paruru-05/SC-26/README.md

# パーツリストはPCB_Partsのそれぞれのファイルから読み取ってください。過去のものは不安定なため確定後に書き直します。
