paruru-05/SC-26/Firmware/free_pins.md

# Free pins:

## Pico2W

### Definitely

- Pin 10
- Pin 11
- Pin 12

### Reserved

- Pin 2 (BNO085_NRST)

## Pico

### Definitely

- Pin 28 (ADC2)
- Pin 27 (ADC1)

### Reserved

- Pin 13 (DRIBBLER_DIR)
- Pin 14 (DRIBBLER_ENABLE)
