paruru-05/SC-26/PCB_Parts/IR_sensor_ring/jlcpcb/production_files/BOM-IR_sensor_ring.csv

Comment | Designator | Footprint | LCSC | Quantity
2.2nF | C1,C10,C11,C12,C13,C14,C15,C16,C2,C3,C4,C5,C6,C7,C8,C9 | C_0603_1608Metric | C1604 | 16
47kΩ | R1,R10,R11,R12,R13,R14,R15,R16,R2,R3,R4,R5,R6,R7,R8,R9 | R_0603_1608Metric | C25819 | 16
Conn_01x05 | J24,J25,J26,J27 | CONN-SMD_5P-P2.00_B6B-PH-SM4-TB-LF-SN | C265085 | 4
VEMD10940FX01 | U1,U10,U11,U12,U13,U14,U15,U16,U2,U3,U4,U5,U6,U7,U8,U9 | LED-SMD_3P-L3.0-W2.0_LTE-S3201L-ZB-HT | C7104273 | 16
