paruru-05/SC-26/PCB_Parts/main_board/jlcpcb/production_files/BOM-main.csv

Comment | Designator | Footprint | LCSC | Quantity
1.6kΩ | R10,R11,R12,R9 | R_0603_1608Metric | C22369888 | 4
1000uF | C23 | CP_Elec_10x10.5 | C7471896 | 1
100kΩ | R16,R17 | R_0603_1608Metric | C25803 | 2
100nF | C1,C2,C22,C25,C3,C31,C32,C33,C34,C4,C5,C6,C7,C8 | C_0603_1608Metric | C14663 | 14
100Ω | R14,R15,R25,R26 | R_0603_1608Metric | C22775 | 4
10kΩ | R13,R27 | R_0603_1608Metric | C25804 | 2
10nF | C17,C18,C19,C20 | C_0603_1608Metric | C57112 | 4
10uF | C24,C28 | C_1206_3216Metric | C13585 | 2
2.2kΩ | R1,R2,R3,R4 | R_0603_1608Metric | C4190 | 4
2.2uH | L1,L2 | L_Coilcraft_XxL4020 | C122469 | 2
2.7kΩ | R18 | R_0603_1608Metric | C13167 | 1
22kΩ | R5,R6,R7,R8 | R_0603_1608Metric | C31850 | 4
22nF | C13,C14,C15,C16 | C_0603_1608Metric | C21122 | 4
22uF | C26,C27 | C_1206_3216Metric | C12891 | 2
3.3nF | C21 | C_0603_1608Metric | C1613 | 1
470nF | C10,C11,C12,C9 | C_0603_1608Metric | C1623 | 4
470Ω | R19,R20,R21,R22 | R_0603_1608Metric | C23179 | 4
ADS1015IDGS | U7 | TSSOP-10_3x3mm_P0.5mm | C193969 | 1
CD74HC4051PWR | U10,U11 | PW16 | C352826 | 2
CJS-1200B | SW2 | CJS-1200B_NDC | C3664500 | 1
Conn_01x03 | J19,J20,J21,J22 | CONN-SMD_B3B-PH-SM4-TB-LF-SN | C160353 | 4
Conn_01x04 | J1,J15,J16,J7,J8 | CONN-SMD_B4B-PH-SM4-TB-LF-SN | C160354 | 5
Conn_01x05 | J17,J24,J25,J26,J27 | CONN-SMD_5P-P2.00_B6B-PH-SM4-TB-LF-SN | C265085 | 5
DRV8874PWPR | U1,U2,U3,U4 | PWP0016J_N | C1855818 | 4
D_Schottky | D5,D6 | D_SMC | C174037 | 2
IRLML6344TRPBF | U8,U9 | IRLML6344TRPBF_INF | C6285738 | 2
KLJ-1230 | LS1 | KLJ-1230_KKG | C201042 | 1
LED | D1 | LED_0603_1608Metric | C2286 | 1
LED | D3 | LED_0603_1608Metric | C2287 | 1
LED | D2 | LED_0603_1608Metric | C2288 | 1
LED | D4 | LED_0603_1608Metric | C52675996 | 1
SW_Push | SW1 | SW-SMD_L3.9-W3.0-P4.45 | C720477 | 1
TLV9064 | U12 | TSSOP-14_4.4x5mm_P0.65mm | C779410 | 1
TPS62133 | U6 | VQFN-16-1EP_3x3mm_P0.5mm_EP1.68x1.68mm_ThermalVias | C73973 | 1
TPS62162DSG | U5 | Texas_DSG0008A_WSON-8-1EP_2x2mm_P0.5mm_EP0.9x1.6mm_ThermalVias | C40256 | 1
