paruru-05/SC-26/PCB_Parts/main_board/main.kicad_pcb

## KiCad design PCB_Parts/main_board/main.kicad_pcb (2026-11-04)

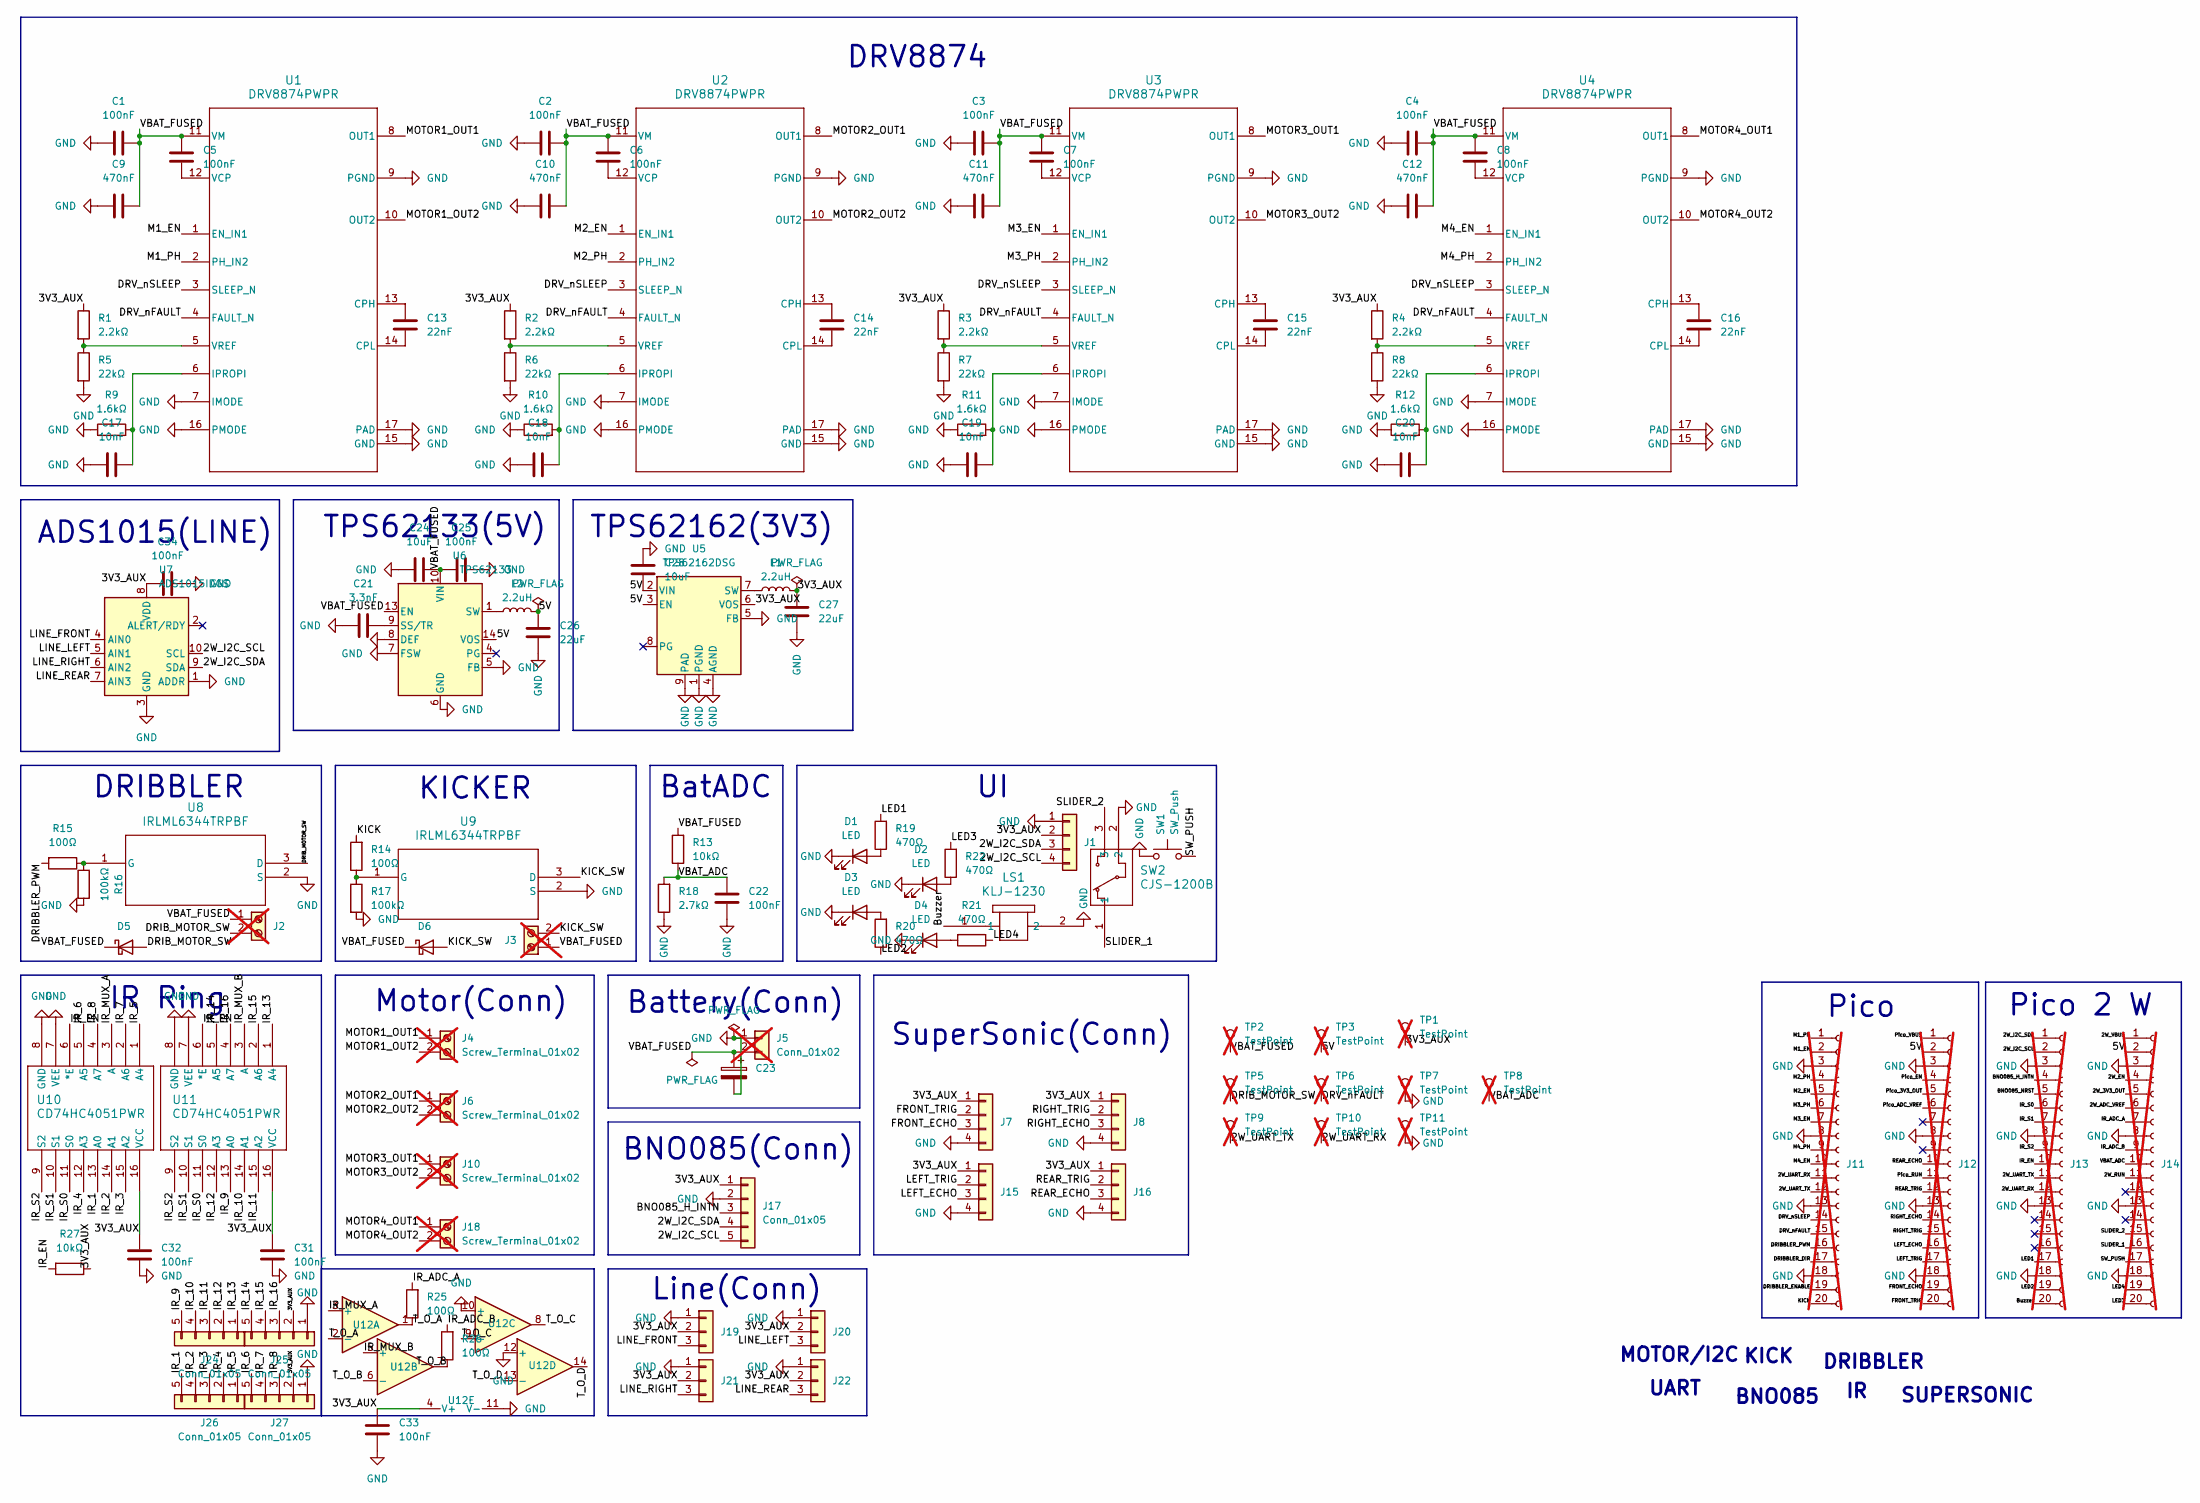
[picture p1: schematic main.kicad_sch, ヾ(•ω•`)o]

Parts:
C1, C2, C3, C4, C5, C6, C7, C8, C22, C25, C31, C32, C33, C34: 100nF; C_0603_1608Metric
C9, C10, C11, C12: 470nF; C_0603_1608Metric
C13, C14, C15, C16: 22nF; C_0603_1608Metric
C17, C18, C19, C20: 10nF; C_0603_1608Metric
C21: 3.3nF; C_0603_1608Metric
C23: 1000uF; CP_Elec_10x10.5
C24, C28: 10uF; C_1206_3216Metric
C26, C27: 22uF; C_1206_3216Metric
D1, D2, D3, D4: LED; LED_0603_1608Metric
D5, D6: D_Schottky; D_SMC
J1, J7, J8, J15, J16: Conn_01x04; CONN-SMD_B4B-PH-SM4-TB-LF-SN
J2, J3, J4, J6, J10, J18: Screw_Terminal_01x02; TerminalBlock_Phoenix_MKDS-1,5-2-5.08_1x02_P5.08mm_Horizont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; not fitted
J5: Conn_01x02; AMASS_XT30PW-M_1x02_P2.50mm_Horizontal; not fitted
J11, J12, J13, J14: Conn_01x20_Socket; PinSocket_1x20_P2.54mm_Vertical; not fitted
J17, J24, J25, J26, J27: Conn_01x05; CONN-SMD_5P-P2.00_B6B-PH-SM4-TB-LF-SN
J19, J20, J21, J22: Conn_01x03; CONN-SMD_B3B-PH-SM4-TB-LF-SN
L1, L2: 2.2uH; L_Coilcraft_XxL4020
LS1: KLJ-1230; KLJ-1230_KKG
R1, R2, R3, R4: 2.2kΩ; R_0603_1608Metric
R5, R6, R7, R8: 22kΩ; R_0603_1608Metric
R9, R10, R11, R12: 1.6kΩ; R_0603_1608Metric
R13, R27: 10kΩ; R_0603_1608Metric
R14, R15, R25, R26: 100Ω; R_0603_1608Metric
R16, R17: 100kΩ; R_0603_1608Metric
R18: 2.7kΩ; R_0603_1608Metric
R19, R20, R21, R22: 470Ω; R_0603_1608Metric
SW1: SW_Push; SW-SMD_L3.9-W3.0-P4.45
SW2: CJS-1200B; CJS-1200B_NDC
TP1, TP2, TP3, TP5, TP6, TP7, TP8, TP9, TP10, TP11: TestPoint; TestPoint_Pad_D3.0mm; not fitted
U1, U2, U3, U4: DRV8874PWPR; PWP0016J_N
U5: TPS62162DSG; Texas_DSG0008A_WSON-8-1EP_2x2mm_P0.5mm_EP0.9x1.6mm_ThermalV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
U6: TPS62133; VQFN-16-1EP_3x3mm_P0.5mm_EP1.68x1.68mm_ThermalVias
U7: ADS1015IDGS; TSSOP-10_3x3mm_P0.5mm
U8, U9: IRLML6344TRPBF; IRLML6344TRPBF_INF
U10, U11: CD74HC4051PWR; PW16
U12: TLV9064; TSSOP-14_4.4x5mm_P0.65mm

Connections:
/2W_3V3_OUT: J14.5
/2W_ADC_VREF: J14.6
/2W_EN: J14.4
/2W_I2C_SCL: J1.4, J13.2, J17.5, U7.10 (SCL)
/2W_I2C_SDA: J1.3, J13.1, J17.4, U7.9 (SDA)
/2W_RUN: J14.11
/2W_UART_RX: J11.11, J13.12, TP10.1 (1_1)
/2W_UART_TX: J11.12, J13.11, TP9.1 (1_1)
/2W_VBUS: J14.1
/3V3_AUX: C27.2, C31.1, C32.2, C33.1, C34.1, J1.2, J7.1, J8.1, J15.1, J16.1, J17.1, J19.2, J20.2, J21.2, J22.2, J25.2, J27.2, L1.2, R1.1, R2.1, R3.1, R4.1, R27.1, TP1.1 (1_1), U5.6 (VOS), U7.8 (VDD), U10.16 (VCC), U11.16 (VCC), U12.4 (V+)
/5V: C26.2, C28.2, J12.2, J14.2, L2.2, TP3.1 (1_1), U5.2 (VIN), U5.3 (EN), U6.14 (VOS)
/BNO085_H_INTN: J13.4, J17.3
/BNO085_NRST: J13.5
/Buzzer: J13.20, LS1.1
/DRIBBLER_DIR: J11.17
/DRIBBLER_ENABLE: J11.19
/DRIBBLER_PWM: J11.16, R15.2
/DRIB_MOTOR_SW: D5.2 (A), J2.2, TP5.1 (1_1), U8.3 (D)
/DRV_nFAULT: J11.15, TP6.1 (1_1), U1.4 (FAULT_N), U2.4 (FAULT_N), U3.4 (FAULT_N), U4.4 (FAULT_N)
/DRV_nSLEEP: J11.14, U1.3 (SLEEP_N), U2.3 (SLEEP_N), U3.3 (SLEEP_N), U4.3 (SLEEP_N)
/FRONT_ECHO: J7.3, J12.19
/FRONT_TRIG: J7.2, J12.20
/IR_1: J26.5, U10.13 (A0)
/IR_2: J26.4, U10.14 (A1)
/IR_3: J26.3, U10.15 (A2)
/IR_4: J26.2, U10.12 (A3)
/IR_5: J26.1, U10.1 (A4)
/IR_6: J27.5, U10.5 (A5)
/IR_7: J27.4, U10.2 (A6)
/IR_8: J27.3, U10.4 (A7)
/IR_9: J24.5, U11.13 (A0)
/IR_10: J24.4, U11.14 (A1)
/IR_11: J24.3, U11.15 (A2)
/IR_12: J24.2, U11.12 (A3)
/IR_13: J24.1, U11.1 (A4)
/IR_14: J25.5, U11.5 (A5)
/IR_15: J25.4, U11.2 (A6)
/IR_16: J25.3, U11.4 (A7)
/IR_ADC_A: J14.7, R25.2
/IR_ADC_B: J14.9, R26.2
/IR_EN: J13.10, R27.2, U10.6 (*E), U11.6 (*E)
/IR_MUX_A: U10.3 (A), U12.3 (+)
/IR_MUX_B: U11.3 (A), U12.5 (+)
/IR_S0: J13.6, U10.11 (S0), U11.11 (S0)
/IR_S1: J13.7, U10.10 (S1), U11.10 (S1)
/IR_S2: J13.9, U10.9 (S2), U11.9 (S2)
/KICK: J11.20, R14.2
/KICK_SW: D6.2 (A), J3.2, U9.3 (D)
/LED1: J13.17, R19.2
/LED2: J13.19, R20.1
/LED3: J14.20, R22.2
/LED4: J14.19, R21.1
/LEFT_ECHO: J12.16, J15.3
/LEFT_TRIG: J12.17, J15.2
/LINE_FRONT: J19.3, U7.4 (AIN0)
/LINE_LEFT: J20.3, U7.5 (AIN1)
/LINE_REAR: J22.3, U7.7 (AIN3)
/LINE_RIGHT: J21.3, U7.6 (AIN2)
/M1_EN: J11.2, U1.1 (EN_IN1)
/M1_PH: J11.1, U1.2 (PH_IN2)
/M2_EN: J11.5, U2.1 (EN_IN1)
/M2_PH: J11.4, U2.2 (PH_IN2)
/M3_EN: J11.7, U3.1 (EN_IN1)
/M3_PH: J11.6, U3.2 (PH_IN2)
/M4_EN: J11.10, U4.1 (EN_IN1)
/M4_PH: J11.9, U4.2 (PH_IN2)
/MOTOR1_OUT1: J4.1, U1.8 (OUT1)
/MOTOR1_OUT2: J4.2, U1.10 (OUT2)
/MOTOR2_OUT1: J6.1, U2.8 (OUT1)
/MOTOR2_OUT2: J6.2, U2.10 (OUT2)
/MOTOR3_OUT1: J10.1, U3.8 (OUT1)
/MOTOR3_OUT2: J10.2, U3.10 (OUT2)
/MOTOR4_OUT1: J18.1, U4.8 (OUT1)
/MOTOR4_OUT2: J18.2, U4.10 (OUT2)
/Pico_3V3_OUT: J12.5
/Pico_ADC_VREF: J12.6
/Pico_EN: J12.4
/Pico_RUN: J12.11
/Pico_VBUS: J12.1
/REAR_ECHO: J12.10, J16.3
/REAR_TRIG: J12.12, J16.2
/RIGHT_ECHO: J8.3, J12.14
/RIGHT_TRIG: J8.2, J12.15
/SLIDER_1: J14.16, SW2.1
/SLIDER_2: J14.15, SW2.3
/SW_PUSH: J14.17, SW1.2
/T_O_A: R25.1, U12.1, U12.2 (-)
/T_O_B: R26.1, U12.6 (-), U12.7
/T_O_C: U12.8, U12.9 (-)
/T_O_D: U12.13 (-), U12.14
/VBAT_ADC: C22.2, J14.10, R13.1, R18.2, TP8.1 (1_1)
/VBAT_FUSED: C1.2, C2.2, C3.2, C4.2, C5.1, C6.1, C7.1, C8.1, C9.2, C10.2, C11.2, C12.2, C23.1, C24.2, C25.2, D5.1 (K), D6.1 (K), J2.1, J3.1, J5.2, R13.2, TP2.1 (1_1), U1.11 (VM), U2.11 (VM), U3.11 (VM), U4.11 (VM), U6.10 (VIN), U6.11 (VIN), U6.12 (VIN), U6.13 (EN)
GND: C1.1, C2.1, C3.1, C4.1, C9.1, C10.1, C11.1, C12.1, C17.1, C18.1, C19.2, C20.1, C21.1, C22.1, C23.2, C24.1, C25.1, C26.1, C27.1, C28.1, C31.2, C32.1, C33.2, C34.2, D1.1 (K), D2.1 (K), D3.1 (K), D4.1 (K), J1.1, J5.1, J7.4, J8.4, J11.3, J11.8, J11.13, J11.18, J12.3, J12.8, J12.13, J12.18, J13.3, J13.8, J13.13, J13.18, J14.3, J14.8, J14.13, J14.18, J15.4, J16.4, J17.2, J19.1, J20.1, J21.1, J22.1, J25.1, J27.1, LS1.2, R5.2, R6.2, R7.2, R8.2, R9.1, R10.1, R11.1, R12.1, R16.2, R17.2, R18.1, SW1.1, SW2.2, TP7.1 (1_1), TP11.1 (1_1), U1.7 (IMODE), U1.9 (PGND), U1.15 (GND), U1.16 (PMODE), U1.17 (PAD), U2.7 (IMODE), U2.9 (PGND), U2.15 (GND), U2.16 (PMODE), U2.17 (PAD), U3.7 (IMODE), U3.9 (PGND), U3.15 (GND), U3.16 (PMODE), U3.17 (PAD), U4.7 (IMODE), U4.9 (PGND), U4.15 (GND), U4.16 (PMODE), U4.17 (PAD), U5.1 (PGND), U5.4 (AGND), U5.5 (FB), U5.9 (PAD), U6.5 (FB), U6.6 (GND), U6.7 (FSW), U6.8 (DEF), U6.15 (GND), U6.16 (GND), U6.17 (GND), U7.1 (ADDR), U7.3 (GND), U8.2 (S), U9.2 (S), U10.7 (VEE), U10.8 (GND), U11.7 (VEE), U11.8 (GND), U12.10 (+), U12.11 (V-), U12.12 (+)
unnamed: D1.2 (A), R19.1
unnamed: D2.2 (A), R22.1
unnamed: D3.2 (A), R20.2
unnamed: D4.2 (A), R21.2
unnamed: L2.1, U6.1 (SW), U6.2 (SW), U6.3 (SW)
unnamed: C13.1, U1.13 (CPH)
unnamed: C13.2, U1.14 (CPL)
unnamed: C17.2, R9.2, U1.6 (IPROPI)
unnamed: C5.2, U1.12 (VCP)
unnamed: R1.2, R5.1, U1.5 (VREF)
unnamed: C14.1, U2.13 (CPH)
unnamed: C14.2, U2.14 (CPL)
unnamed: C18.2, R10.2, U2.6 (IPROPI)
unnamed: C6.2, U2.12 (VCP)
unnamed: R2.2, R6.1, U2.5 (VREF)
unnamed: C15.1, U3.13 (CPH)
unnamed: C15.2, U3.14 (CPL)
unnamed: C19.1, R11.2, U3.6 (IPROPI)
unnamed: C7.2, U3.12 (VCP)
unnamed: R3.2, R7.1, U3.5 (VREF)
unnamed: C16.1, U4.13 (CPH)
unnamed: C16.2, U4.14 (CPL)
unnamed: C20.2, R12.2, U4.6 (IPROPI)
unnamed: C8.2, U4.12 (VCP)
unnamed: R4.2, R8.1, U4.5 (VREF)
unnamed: L1.1, U5.7 (SW)
unnamed: C21.2, U6.9 (SS/TR)
unnamed: R15.1, R16.1, U8.1 (G)
unnamed: R14.1, R17.1, U9.1 (G)

Notes on the sheet:
KICKER
BNO085(Conn)
DRIBBLER
SUPERSONIC
TPS62162(3V3)
SuperSonic(Conn)
BNO085
BatADC
DRV8874
TPS62133(5V)
KICK
Line(Conn)
UART
Pico
Pico 2 W
Battery(Conn)
IR Ring
MOTOR/I2C
ADS1015(LINE)
Motor(Conn)

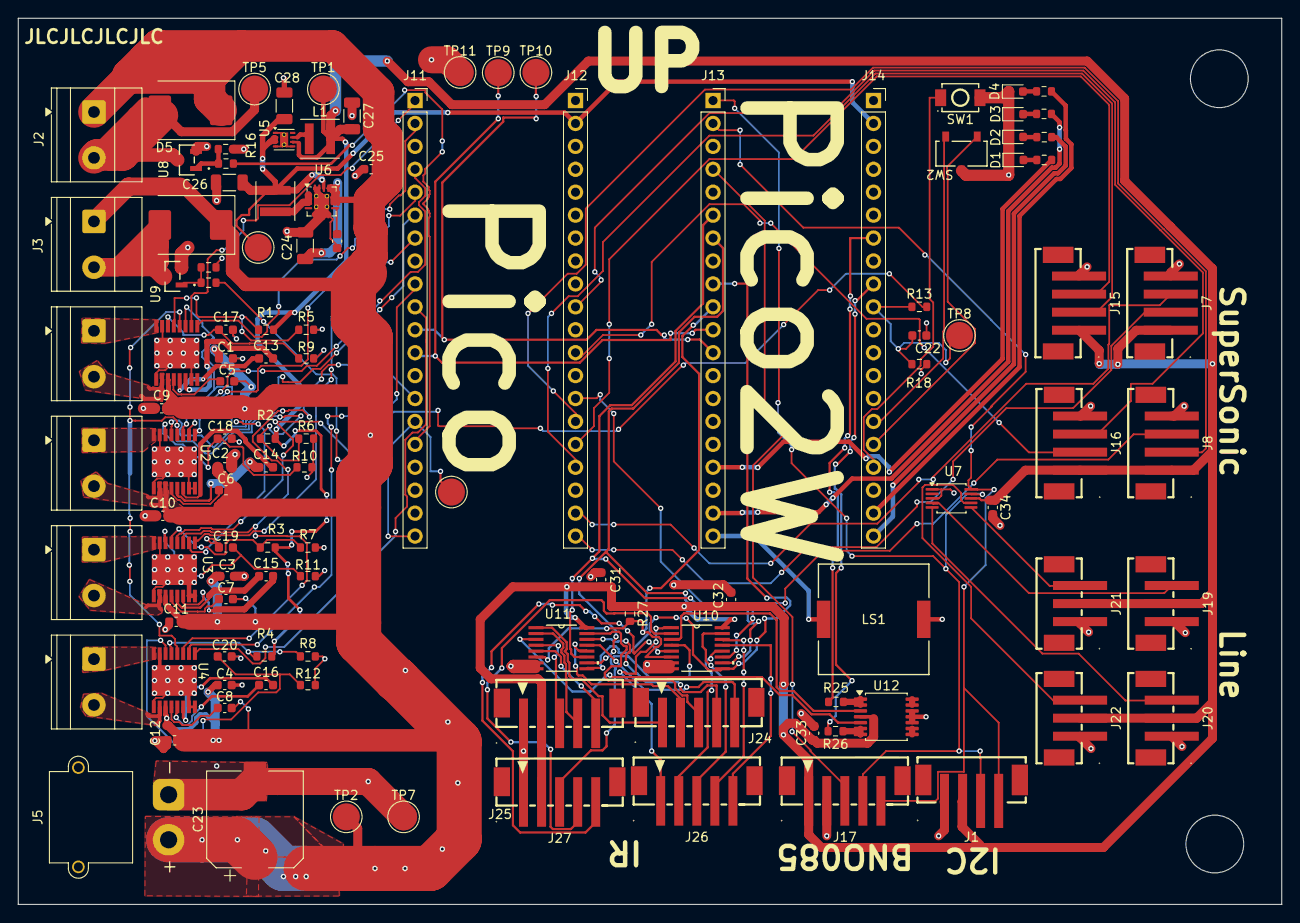
[picture p2: board main.kicad_pcb from above]

Board: 2 copper layers, 140.0 x 98.2 mm, 115 parts (0 on the bottom side), 109 nets.
