paruru-05/SC-26/PCB_Parts/IR_sensor_ring/IR_sensor_ring.kicad_pcb

## KiCad design PCB_Parts/IR_sensor_ring/IR_sensor_ring.kicad_pcb (2026-11-04)

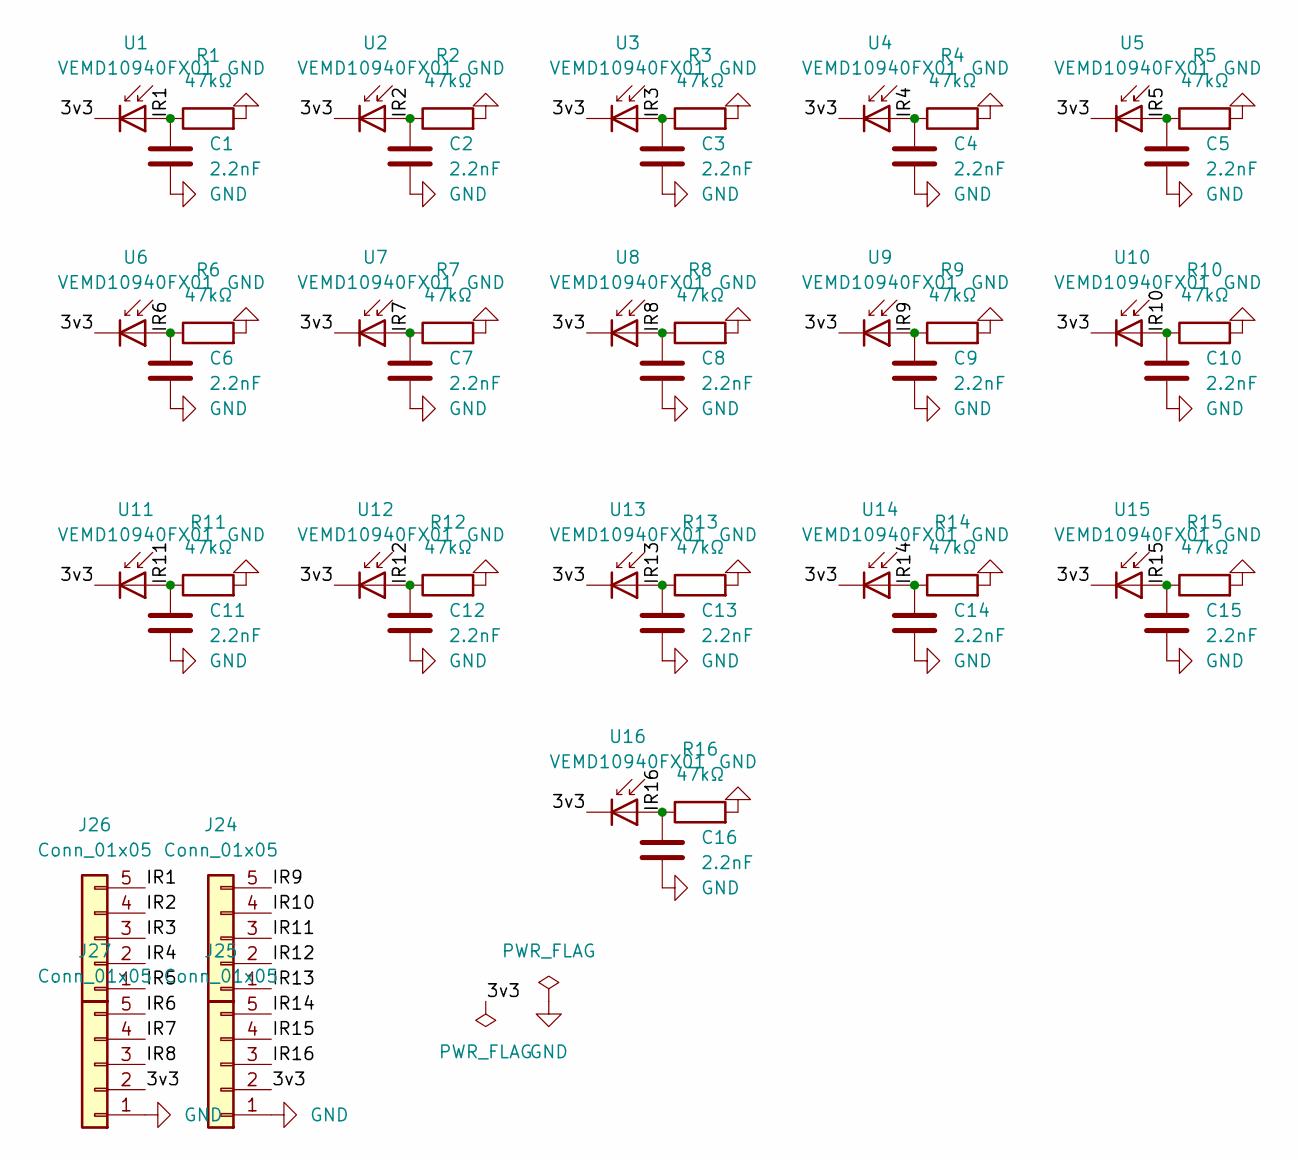
[picture p3: schematic IR_sensor_ring.kicad_sch]

Parts:
C1, C2, C3, C4, C5, C6, C7, C8, C9, C10, C11, C12, C13, C14, C15, C16: 2.2nF; C_0603_1608Metric; LCSC Part C1604
J24, J25, J26, J27: Conn_01x05; CONN-SMD_5P-P2.00_B6B-PH-SM4-TB-LF-SN
R1, R2, R3, R4, R5, R6, R7, R8, R9, R10, R11, R12, R13, R14, R15, R16: 47kΩ; R_0603_1608Metric; LCSC Part C25819
U1, U2, U3, U4, U5, U6, U7, U8, U9, U10, U11, U12, U13, U14, U15, U16: VEMD10940FX01; LED-SMD_3P-L3.0-W2.0_LTE-S3201L-ZB-HT; MPN VEMD10940FX01; LCSC Part C7104273

Connections:
/3v3: J25.2, J27.2, U1.1 (K), U2.1 (K), U3.1 (K), U4.1 (K), U5.1 (K), U6.1 (K), U7.1 (K), U8.1 (K), U9.1 (K), U10.1 (K), U11.1 (K), U12.1 (K), U13.1 (K), U14.1 (K), U15.1 (K), U16.1 (K)
/IR1: C1.2, J26.5, R1.1, U1.2 (A)
/IR2: C2.2, J26.4, R2.1, U2.2 (A)
/IR3: C3.2, J26.3, R3.1, U3.2 (A)
/IR4: C4.2, J26.2, R4.1, U4.2 (A)
/IR5: C5.2, J26.1, R5.1, U5.2 (A)
/IR6: C6.2, J27.5, R6.1, U6.2 (A)
/IR7: C7.2, J27.4, R7.1, U7.2 (A)
/IR8: C8.2, J27.3, R8.1, U8.2 (A)
/IR9: C9.2, J24.5, R9.1, U9.2 (A)
/IR10: C10.2, J24.4, R10.1, U10.2 (A)
/IR11: C11.2, J24.3, R11.1, U11.2 (A)
/IR12: C12.2, J24.2, R12.1, U12.2 (A)
/IR13: C13.2, J24.1, R13.1, U13.2 (A)
/IR14: C14.2, J25.5, R14.1, U14.2 (A)
/IR15: C15.2, J25.4, R15.1, U15.2 (A)
/IR16: C16.2, J25.3, R16.1, U16.2 (A)
GND: C1.1, C2.1, C3.1, C4.1, C5.1, C6.1, C7.1, C8.1, C9.1, C10.1, C11.1, C12.1, C13.1, C14.1, C15.1, C16.1, J25.1, J27.1, R1.2, R2.2, R3.2, R4.2, R5.2, R6.2, R7.2, R8.2, R9.2, R10.2, R11.2, R12.2, R13.2, R14.2, R15.2, R16.2

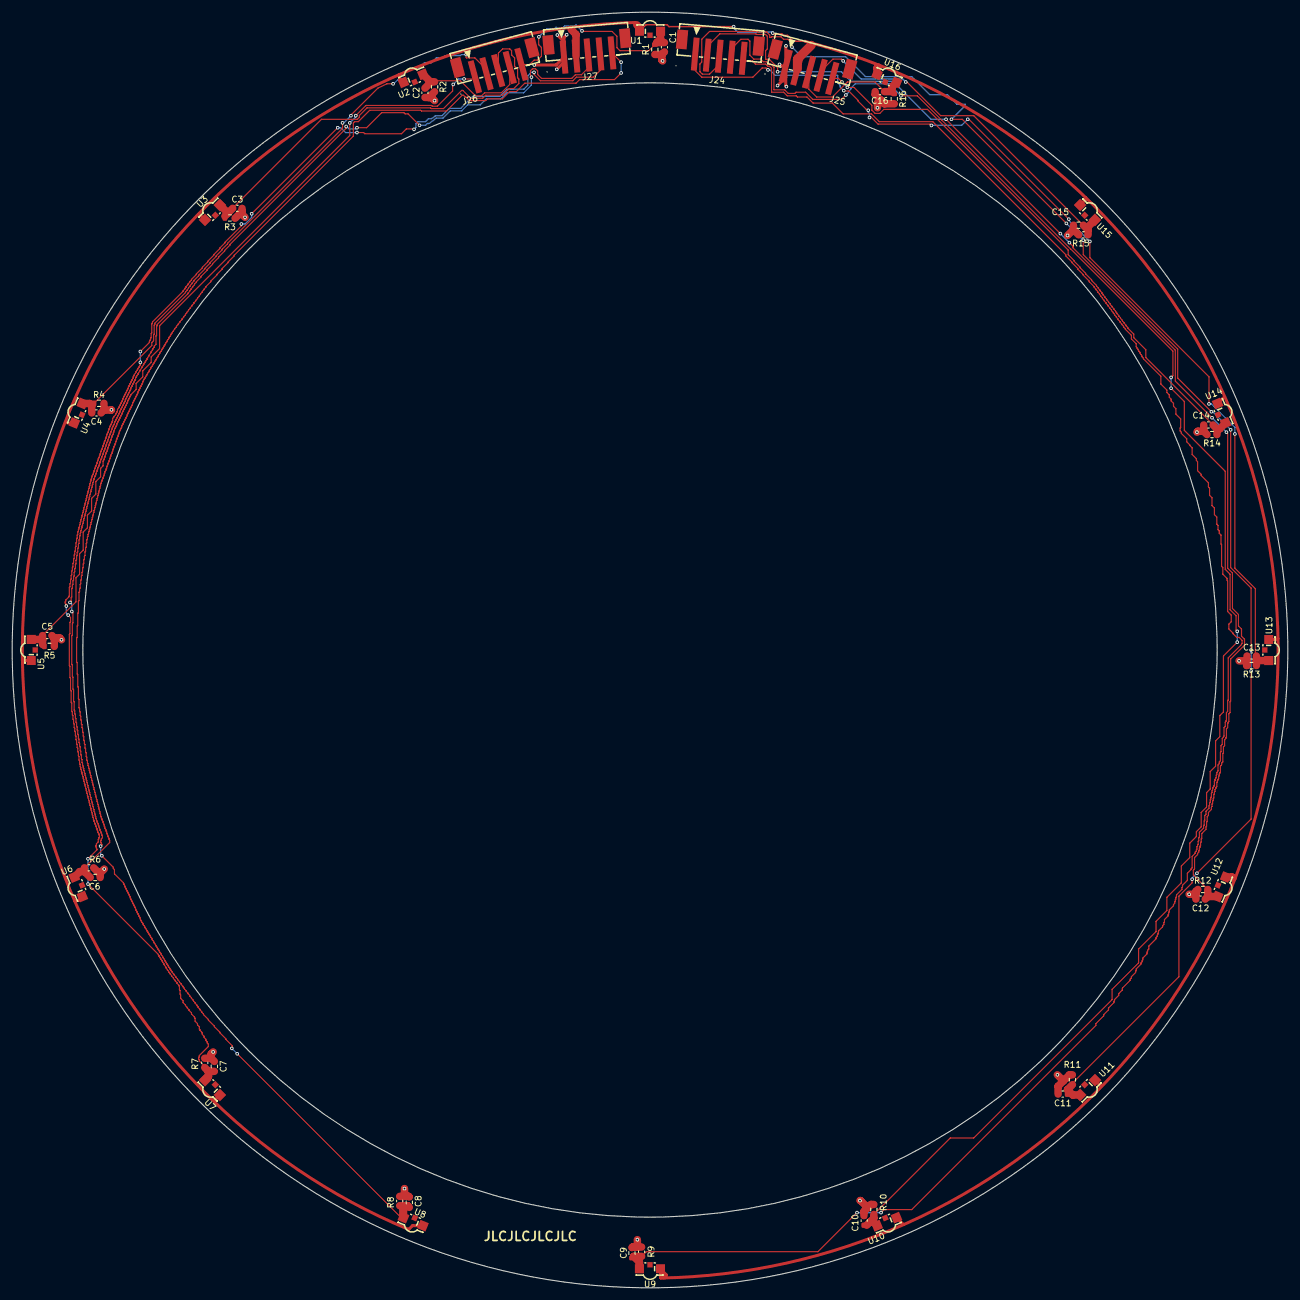
[picture p4: board IR_sensor_ring.kicad_pcb from above]

Board: 2 copper layers, 212.0 x 212.0 mm, 52 parts (0 on the bottom side), 18 nets.
