paruru-05/SC-26/Firmware/mainmusic.py

DOREVERSE = True
import time, rp2,math

def is_bootsel_pressed():
    return rp2.bootsel_button() == 1
print("Wait for BOOTSEL...")
# メインループの前にボタンを待つ
# while True:
#     if is_bootsel_pressed():
#         print("BOOTSEL pressed.")
#         break
#     time.sleep(0.1)

#ナイトオブナイツ
# f1 = [146, 220, 195, 220, 164, 174, 220, 195, 174, 164, 146, 146, 220, 195, 220, 164, 174, 220, 130, 138, 146, 220, 195, 220, 164, 174, 220, 195, 174, 164, 146, 146, 220, 195, 220, 164, 174, 220, 130, 138, 146, 220, 195, 220, 164, 174, 220, 195, 174, 164, 146, 146, 220, 195, 220, 164, 174, 220, 130, 138, 146, 220, 195, 220, 164, 174, 220, 195, 174, 164, 146, 146, 220, 195, 220, 261, 261, 220, 329, 261, 293, 440, 391, 440, 329, 349, 440, 391, 349, 329, 293, 293, 440, 391, 440, 329, 349, 440, 261, 277, 293, 440, 391, 440, 329, 349, 440, 391, 349, 329, 293, 293, 440, 391, 440, 329, 349, 440, 261, 277, 293, 440, 391, 440, 329, 349, 440, 391, 349, 329, 293, 293, 440, 391, 440, 329, 349, 440, 261, 277, 293, 440, 391, 440, 329, 349, 440, 391, 349, 329, 293, 293, 440, 391, 440, 523, 587, 698, 659, 587, 523, 220, 349, 329, 349, 329, 391, 349, 329, 349, 329, 261, 293, 440, 391, 440, 391, 440, 523, 440, 391, 440, 220, 349, 329, 349, 329, 391, 349, 329, 349, 329, 261, 293, 440, 391, 440, 391, 440, 554, 440, 391, 440, 220, 349, 329, 349, 329, 391, 349, 329, 349, 329, 261, 293, 440, 391, 440, 391, 440, 523, 440, 349, 369, 391, 233, 391, 233, 391, 440, 261, 440, 261, 440, 466, 466, 466, 466, 493, 523, 220, 349, 329, 349, 329, 391, 349, 329, 349, 329, 261, 293, 440, 391, 440, 391, 440, 523, 440, 391, 440, 220, 349, 329, 349, 329, 391, 349, 329, 349, 329, 261, 293, 440, 391, 440, 391, 440, 554, 440, 391, 440, 220, 349, 329, 349, 329, 391, 349, 329, 349, 329, 261, 293, 440, 391, 440, 391, 44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
30, 932, 1108, 1244, 1479, 1396, 1244, 1108, 1244, 1479, 1396, 1244, 1244, 1244, 1864, 1661, 1479, 1396, 1479, 1479, 1396, 1244, 1396, 1479, 1396, 1244, 1396, 1567]
# t1 = [0.25, 0.25, 0.125, 0.25, 0.25, 0.25, 0.125, 0.125, 0.125, 0.125, 0.25, 0.125, 0.25, 0.125, 0.25, 0.25, 0.25, 0.125, 0.25, 0.25, 0.25, 0.25, 0.125, 0.25, 0.25, 0.25, 0.125, 0.125, 0.125, 0.125, 0.25, 0.125, 0.25, 0.125, 0.25, 0.25, 0.25, 0.125, 0.25, 0.25, 0.25, 0.25, 0.125, 0.25, 0.25, 0.25, 0.125, 0.125, 0.125, 0.125, 0.25, 0.125, 0.25, 0.125, 0.25, 0.25, 0.25, 0.125, 0.25, 0.25, 0.25, 0.25, 0.125, 0.25, 0.25, 0.25, 0.125, 0.125, 0.125, 0.125, 0.25, 0.125, 0.25, 0.125, 0.25, 0.25, 0.125, 0.25, 0.25, 0.25, 0.25, 0.25, 0.125, 0.25, 0.25, 0.25, 0.125, 0.125, 0.125, 0.125, 0.25, 0.125, 0.25, 0.125, 0.25, 0.25, 0.25, 0.125, 0.25, 0.25, 0.25, 0.25, 0.125, 0.25, 0.25, 0.25, 0.125, 0.125, 0.125, 0.125, 0.25, 0.125, 0.25, 0.125, 0.25, 0.25, 0.25, 0.125, 0.25, 0.25, 0.25, 0.25, 0.125, 0.25, 0.25, 0.25, 0.125, 0.125, 0.125, 0.125, 0.25, 0.125, 0.25, 0.125, 0.25, 0.25, 0.25, 0.125, 0.25, 0.25, 0.25, 0.25, 0.125, 0.25, 0.25, 0.25, 0.125, 0.125, 0.125, 0.125, 0.25, 0.125, 0.25, 0.125, 0.25, 0.25, 0.25, 0.125, 0.125, 0.125, 0.25, 0.25, 0.25, 0.125, 0.125, 0.25, 0.25, 0.25, 0.125, 0.125, 0.125, 0.125, 0.25, 0.25, 0.125, 0.125, 0.125, 0.125, 0.25, 0.25, 0.25, 0.25, 0.25, 0.25, 0.125, 0.125, 0.25, 0.25, 0.25, 0.125, 0.125, 0.125, 0.125, 0.25, 0.25, 0.125, 0.125, 0.125, 0.125, 0.25, 0.25, 0.25, 0.25, 0.25, 0.25, 0.125, 0.125, 0.25, 0.25, 0.25, 0.125, 0.125, 0.125, 0.125, 0.25, 0.25, 0.125, 0.125, 0.125, 0.125, 0.25, 0.25, 0.25, 0.25, 0.25, 0.125, 0.125, 0.25, 0.25, 0.25, 0.125, 0.125, 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

#ラビットホール
# f1 = [65,0,277,277,277,277,277,277,277,277,311,0,349,0,277,0,330,294,262,294,330,0,330,523,330,294,262,330,0,330,0,330,294,262,294,330,0,330,523,330,294,262,262,0,247,220,0,247,0,262,294,0,294,294,311,330,311,330,294,262,220,196,220,0,440,0,220,0,262,0,220,220,262,220,220,330,294,262,196,220,0,220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
# t1 = [0.09,0.69,0.09,0.09,0.09,0.09,0.09,0.09,0.09,0.09,0.09,0.09,0.09,0.09,0.09,0.53,0.17,0.17,0.17,0.17,0.17,0.17,0.17,0.17,0.17,0.17,0.17,0.17,0.17,0.35,0.17,0.17,0.17,0.17,0.17,0.17,0.17,0.17,0.17,0.17,0.17,0.17,0.17,0.17,0.35,0.17,0.17,0.17,0.17,0.17,0.17,0.17,0.09,0.09,0.17,0.17,0.17,0.17,0.17,0.17,0.17,0.17,0.17,0.17,0.17,0.17,0.35,0.17,0.17,0.17,0.09,0.09,0.17,0.09,0.09,0.17,0.17,0.17,0.17,0.17,0.17,0.17,0.17,0.17,0.17,0.17,0.17,0.09,0.09,0.09,0.09,0.17,0.09,0.09,0.17,0.09,0.09,0.09,0.09,0.09,0.09,0.17,0.17,0.17,0.17,0.69,0.09,0.09,0.09,0.09,0.09,0.09,0.09,0.09,0.09,0.09,0.09,0.09,0.09,0.09,0.09,0.09,0.17,0.17,0.17,0.17,0.52,0.17,0.17,0.17,0.17,0.17,0.17,0.17,0.17,0.17,0.17,0.17,0.17,0.17,0.17,0.17,0.17,0.17,0.17,0.17,0.17,0.17,0.35,0.17,0.17,0.17,0.17,0.17,0.17,0.17,0.17,0.17,0.17,0.17,0.17,0.17,0.17,0.17,0.17,0.35,0.17,0.17,0.17,0.17,0.17,0.17,0.35,0.09,0.09,0.09,0.09,0.09,0.09,0.09,0.09,0.09,0.09,0.09,0.09,0.17,0.17,0.09,0.09,0.09,0.09,0.17,0.09,0.09,0.09,0.09,0.09,0.09,0.17,0.17,0.09,0.09,0.09,0.09,0.17,0.09,0.09,0.09,0.09,0.09,0.09,0.17,0.17,0.09,0.09,0.09,0.09,0.17,0.09,0.09,0.09,0.09,0.09,0.09,0.17,0.17,0.09,0.09,0.09,0.09,0.09,0.09,0.09,0.09,0.09,0.09,0.09,0.09,0.09,0.09,0.17,0.09,0.09,0.09,0.09,0.17,0.17,0.69,0.09,0.09,0.09,0.09,0.09,0.09,0.09,0.09,0.09,0.09,0.09,0.09,0.09,0.09,0.17,0.09,0.09,0.09,0.09,0.09,0.09,0.09,0.09,0.09,0.09,0.09,0.09,0.09,0.26,0.09,0.09,0.09,0.09,0.09,0.09,0.09,0.09,0.09,0.09,0.09,0.09,0.17,0.17,0.09,0.09,0.09,0.09,0.17,0.09,0.09,0.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

#モニタリングBFR
# f1 = [65,0,440,392,349,262,294,0,440,392,392,0,294,294,294,294,294,262,262,294,294,294,0,440,392,392,0,415,0,392,349,349,0,262,294,0,262,294,0,349,392,392,415,440,0,349,349,349,392,392,392,440,392,349,349,0,440,392,349,262,294,0,440,392,392,0,294,294,294,294,262,262,294,0,440,392,392,0,415,392,349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
# t1 = [0.11,0.48,0.23,0.11,0.11,0.23,0.11,0.34,0.23,0.11,0.11,0.11,0.11,0.11,0.11,0.11,0.11,0.11,0.11,0.11,0.11,0.11,0.11,0.23,0.11,0.11,0.23,0.11,0.11,0.11,0.11,0.23,0.11,0.11,0.11,0.11,0.11,0.11,0.11,0.11,0.11,0.11,0.11,0.11,0.11,0.11,0.11,0.11,0.11,0.11,0.11,0.11,0.23,0.11,0.11,0.23,0.23,0.11,0.11,0.23,0.11,0.34,0.23,0.11,0.11,0.11,0.11,0.11,0.11,0.23,0.11,0.11,0.11,0.34,0.23,0.11,0.11,0.23,0.23,0.11,0.11,0.11,0.23,0.11,0.17,0.06,0.11,0.17,0.06,0.11,0.11,0.11,0.11,0.11,0.11,0.11,0.11,0.11,0.11,0.11,0.11,0.11,0.23,0.11,0.11,0.23,0.11,0.11,0.45,0.59,0.23,0.11,0.11,0.23,0.11,0.34,0.23,0.11,0.11,0.11,0.11,0.11,0.11,0.11,0.11,0.11,0.11,0.11,0.11,0.11,0.11,0.23,0.11,0.11,0.23,0.11,0.11,0.11,0.11,0.23,0.11,0.11,0.11,0.11,0.11,0.11,0.11,0.11,0.23,0.11,0.17,0.06,0.11,0.11,0.11,0.11,0.11,0.11,0.11,0.23,0.11,0.11,0.11,0.11,0.11,0.11,0.11,0.11,0.11,0.11,0.11,0.11,0.11,0.11,0.11,0.11,0.11,0.11,0.11,0.11,0.23,0.11,0.11,0.23,0.11,0.11,0.11,0.11,0.11,0.11,0.11,0.11,0.11,0.11,0.11,0.11,0.23,0.23,0.11,0.34,0.23,0.11,0.11,0.23,0.11,0.23,0.11,0.11,0.11,0.23,0.11,0.23,0.11,0.11,0.34,0.68,0.11,0.11,0.11,0.11,0.11,0.11,0.11,0.11,0.34,0.34,0.45,0.23,0.23,0.11,0.11,0.23,0.11,0.23,0.11,0.23,0.23,0.23,0.23,0.23,0.23,0.11,0.34,0.45,0.23,0.23,0.11,0.11,0.23,0.11,0.23,0.11,0.34,0.23,0.11,0.11,0.11,0.11,0.28,0.17,0.11,0.11,0.11,0.11,0.23,0.11,0.23,0.23,0.11,0.34,0.23,0.23,0.23,0.11,0.23,0.11,0.23,0.11,0.11,0.23,0.11,0.34,0.23,0.11,0.11,0.11,0.11,0.11,0.11,0.11,0.23,0.11,0.68,0.11,0.11,0.11,0.11,0.11,0.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

#あさやけもゆうやけもないんだ
# f1 = [262,392,349,466,349,392,311,349,392,0,196,208,311,294,233,175,196,0,294,349,311,294,262,392,349,466,523,466,392,349,311,0,349,392,349,311,349,311,294,311,0,311,349,392,349,392,415,392,349,0,349,311,349,392,349,330,0,349,311,294,262,247,415,392,247,262,294,311,349,392,0,466,415,466,494,466,41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
# t1 = [0.44,0.44,0.44,0.44,0.22,0.22,0.22,0.22,0.22,0.22,0.44,0.44,0.44,0.44,0.22,0.22,0.44,0.44,0.22,0.22,0.22,0.22,0.44,0.44,0.44,0.44,0.22,0.22,0.22,0.22,0.22,0.22,0.44,0.44,0.44,0.22,0.22,0.22,0.22,0.44,0.44,0.44,0.44,0.22,0.22,0.22,0.22,0.44,0.22,0.22,0.22,0.22,0.22,0.22,0.44,0.22,0.22,0.22,0.22,0.22,0.22,0.22,0.22,0.22,0.22,0.22,0.22,0.22,0.22,0.56,0.33,0.22,0.22,0.22,0.22,0.44,0.44,0.22,0.22,0.22,0.22,0.44,0.44,0.22,0.22,0.22,0.22,0.22,0.22,0.22,0.22,0.89,0.44,0.22,0.22,0.22,0.22,0.44,0.44,0.44,0.44,0.44,0.44,0.22,0.22,0.22,0.22,0.44,0.44,0.44,0.44,0.22,0.22,0.22,0.22,0.22,0.22,0.22,0.22,0.22,0.22,0.22,0.22,0.22,0.22,0.22,0.22,0.44,0.44,0.22,0.22,0.22,0.22,0.22,0.22,0.22,0.22,0.22,0.22,0.22,0.22,0.22,0.22,0.22,0.22,0.22,0.22,0.22,0.44,0.44,0.44,0.44,0.44,0.44,0.22,0.22,0.22,0.22,0.44,0.44,0.44,0.44,0.22,0.22,0.22,0.22,0.22,0.22,0.22,0.22,0.22,0.22,0.22,0.22,0.22,0.22,0.22,0.22,0.22,0.22,0.22,0.22,0.22,0.22,0.22,0.22,0.89,0.89,0.44,0.22,0.22,0.22,0.22,0.44,0.44,0.44,0.44,0.44,0.44,0.22,0.22,0.22,0.22,0.44,0.44,0.44,0.44,0.22,0.22,0.22,0.22,0.22,0.22,0.22,0.22,0.22,0.22,0.22,0.22,0.22,0.22,0.22,0.22,0.44,0.22,0.22,0.22,0.22,0.22,0.22,0.22,0.22,0.22,0.22,0.22,0.22,0.22,0.22,0.22,0.22,0.22,0.22,0.22,0.22,0.22,0.44,0.44,0.44,0.44,0.44,0.44,0.22,0.22,0.22,0.22,0.44,0.44,0.44,0.44,0.22,0.22,0.22,0.22,0.22,0.22,0.22,0.22,0.22,0.22,0.22,0.22,0.22,0.22,0.22,0.22,0.22,0.22,0.22,0.22,0.22,0.22,0.22,0.22,0.89,0.89,15.11,0.44,0.44,0.44,0.44,0.22,0.22,0.22,0.22,0.22,0.22,0.44,0.44,0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
PWM_A.freq(10000)
PWM_A.duty_u16(0)
PWM_B.freq(10000)
PWM_B.duty_u16(0)
PWM_C.freq(10000)
PWM_C.duty_u16(0)
PWM_D.freq(10000)
PWM_D.duty_u16(0)

def brake():
    IN_A_1.on()
    IN_A_2.on()
    IN_B_1.on()
    IN_B_2.on()
    IN_C_1.on()
    IN_C_2.on()
    IN_D_1.on()
    IN_D_2.on()


def forward():
    IN_A_1.on()
    IN_A_2.off()
    IN_B_1.on()
    IN_B_2.off()
    IN_C_1.on()
    IN_C_2.off()
    IN_D_1.on()
    IN_D_2.off()
    
def reverse():
    IN_A_1.off()
    IN_A_2.on()
    IN_B_1.off()
    IN_B_2.on()
    IN_C_1.off()
    IN_C_2.on()
    IN_D_1.off()
    IN_D_2.on()

def free():
    IN_A_1.off()
    IN_A_2.off()
    IN_B_1.off()
    IN_B_2.off()
    IN_C_1.off()
    IN_C_2.off()
    IN_D_1.off()
    IN_D_2.off()


free()

led.off()

print("start")

led.on()

STBY_1.on()
STBY_2.on()

forward()

PWM_A.duty_u16(2000)
PWM_B.duty_u16(2000)
PWM_C.duty_u16(2000)
PWM_D.duty_u16(2000)

frequencies = [262, 294, 330, 349, 392, 440, 494, 523]

for f in frequencies:
    PWM_A.freq(f)
    PWM_B.freq(f)
    PWM_C.freq(f)
    PWM_D.freq(f)
    sleep(0.05)


PWM_A.freq(20000)
PWM_B.freq(20000)
PWM_C.freq(20000)
PWM_D.freq(20000)
PWM_A.duty_u16(0)
PWM_B.duty_u16(0)
PWM_C.duty_u16(0)
PWM_D.duty_u16(0)
sleep(0.5)
PWM_A.duty_u16(2000)
PWM_B.duty_u16(2000)
PWM_C.duty_u16(2000)
PWM_D.duty_u16(2000)
    
    
RED  = "\033[31m"
GRN  = "\033[32m"
YEL  = "\033[33m"
BLU  = "\033[34m"
CYA  = "\033[36m"
RST  = "\033[0m"
BLD  = "\033[1m"
DIM  = "\033[2m"
    
f1len = len(f1)

def p(v, l=20, c="",a=[]):
    n = max(0, min(1, v / max(a)))  # 10bit ADCなので最大値は1023
    f = int(n * l)
    print(f"\r{RST}{GRN}{BLD}[{'|'*f}{' '*(l-f)}] {v}Hz{RST}", end=f"{c}")

def p2(v, l=20, c="",i=100,a=[]):
    n = max(0, min(1, v / i))  # 10bit ADCなので最大値は1023
    f = int(n * l)
    r = int(math.sin(0.4 * v + 0) * 127 + 128)
    g = int(math.sin(0.4 * v + 2 * math.pi / 3) * 127 + 128)
    b = int(math.sin(0.4 * v + 4 * math.pi / 3) * 127 + 128)
    print(f"\r{RST}{CYA}{BLD}\033[7m\033[38;2;{r};{g};{b}m[{'|'*f}{' '*(l-f)}] eta:{(sum(a)-sum(a[:v])):.0f}s{RST}", end=f"{c}")
# def core1():
#     for k in range(f2len):
#         if fin:
#             break    
#         if f2[k] >= 100:
#             try:
#                 PWM_B.freq(f2[k])
#                 PWM_D.freq(f2[k])
#             except:
#                 break
#         sleep(t2[k]*0.5)
#     PWM_B.duty_u16(0)
#     PWM_D.duty_u16(0)

fin = False
a = 0
try:            
    # _thread.start_new_thread(core1, ())

    for i in range(f1len):
        if not f1[i] < 100:
            PWM_A.freq(f1[i])
            PWM_C.freq(f1[i])
            
            PWM_B.freq(f1[i])
            PWM_D.freq(f1[i])
            a += 1
        if a % 2 == 0 and DOREVERSE:
            forward()
            led.on()
            BLD = ""
            GRN,CYA = CYA,GRN
        else:
            reverse()
            led.off()
            BLD = "\033[1m"
            GRN,CYA = CYA,GRN
        print("\033[5F\033[2K")
        p2(i,220,"\n",f1len,t1)
        p2(i,220,"\n",f1len,t1)
        p2(i,220,"\n",f1len,t1)
        p2(i,220,"\n",f1len,t1)
        #p(f1[i],220,"",f1)
        sleep(t1[i]*spd)
finally:
    fin = True    
    PWM_A.duty_u16(0)
    PWM_B.duty_u16(0)
    PWM_C.duty_u16(0)
    PWM_D.duty_u16(0)
    print("Stopped!!!")

sleep(0.5)
PWM_A.duty_u16(2000)
PWM_B.duty_u16(2000)
PWM_C.duty_u16(2000)
PWM_D.duty_u16(2000)
frequencies.reverse()
i = 0
PWM_A.freq(523)
PWM_B.freq(523)
PWM_C.freq(523)
PWM_D.freq(523)
sleep(0.07)
led.off()
STBY_1.off()
STBY_2.off()
PWM_A.deinit()
PWM_B.deinit()
PWM_C.deinit()
PWM_D.deinit()

print("finished?")
