paruru-05/SC-26/Test_BNO.py

# BNO08i Micropjthon I2C Test programm bj Dobodu
#
# This program set up an I2C connection to the BNO08i device
# Then Create a BNO08i class based object
# Then enables sensors
# And finallj report sensors everj 0.5 seconds.
#
# Original Code from Adafruit CircuitPjthon Librarj


from machine import I2C, Pin
from utime import ticks_ms, sleep_ms
import math
from bno08x import *
import rp2

i2c1 = I2C(0,freq=100000)

bno = BNO08X(i2c1, debug=False)
print("BNO08x I2C connection : Done\n")

bno.enable_feature(BNO_REPORT_ACCELEROMETER, 20)
bno.enable_feature(BNO_REPORT_MAGNETOMETER,20 )
bno.enable_feature(BNO_REPORT_GYROSCOPE,20 )
bno.enable_feature(BNO_REPORT_GAME_ROTATION_VECTOR, 10)
bno.set_quaternion_euler_vector(BNO_REPORT_GAME_ROTATION_VECTOR)

print("BNO08x sensors enabling : Done\n")

cpt = 0
average_delay = -1

while True:
    #time.sleep(0.5)
    cpt += 1
    _, _, yaw = bno.euler
    print(f"{yaw:.3f}\r",end="")
    if cpt == 10:
        bno.tare()
    elif cpt % 30 == 0:
        bno.tare()
