paruru-05/SC-26/(commit log)

2026-04-19 慣性です
2026-04-19 もう一回完成h
2026-04-20 Update README with revised budget and item list
    Removed the connector cable entry and updated totals.
2026-04-20 Update README with new sensor and budget details
2026-06-10 アップデート
2026-07-25 7/25 モータードライバーの管理・ベクトル演算の確立
2026-07-26 かなり進化
2026-07-27 7/27 トレース基本形でけた
2026-07-28 7/28 交差点クリアъ(`･ω･´)ｸﾞｯ
2026-07-28 7/28 狂った(;_;)
2026-09-28 CAD st
    [IR_sensor_ring.kicad_pcb, IR_sensor_ring.kicad_sch, main.kicad_pcb, main.kicad_sch]
2026-11-05 整理整頓&改革開始
